flaviut/fan-controller/fan-controller.kicad_pcb

## KiCad design fan-controller.kicad_pcb (2024-07-13)

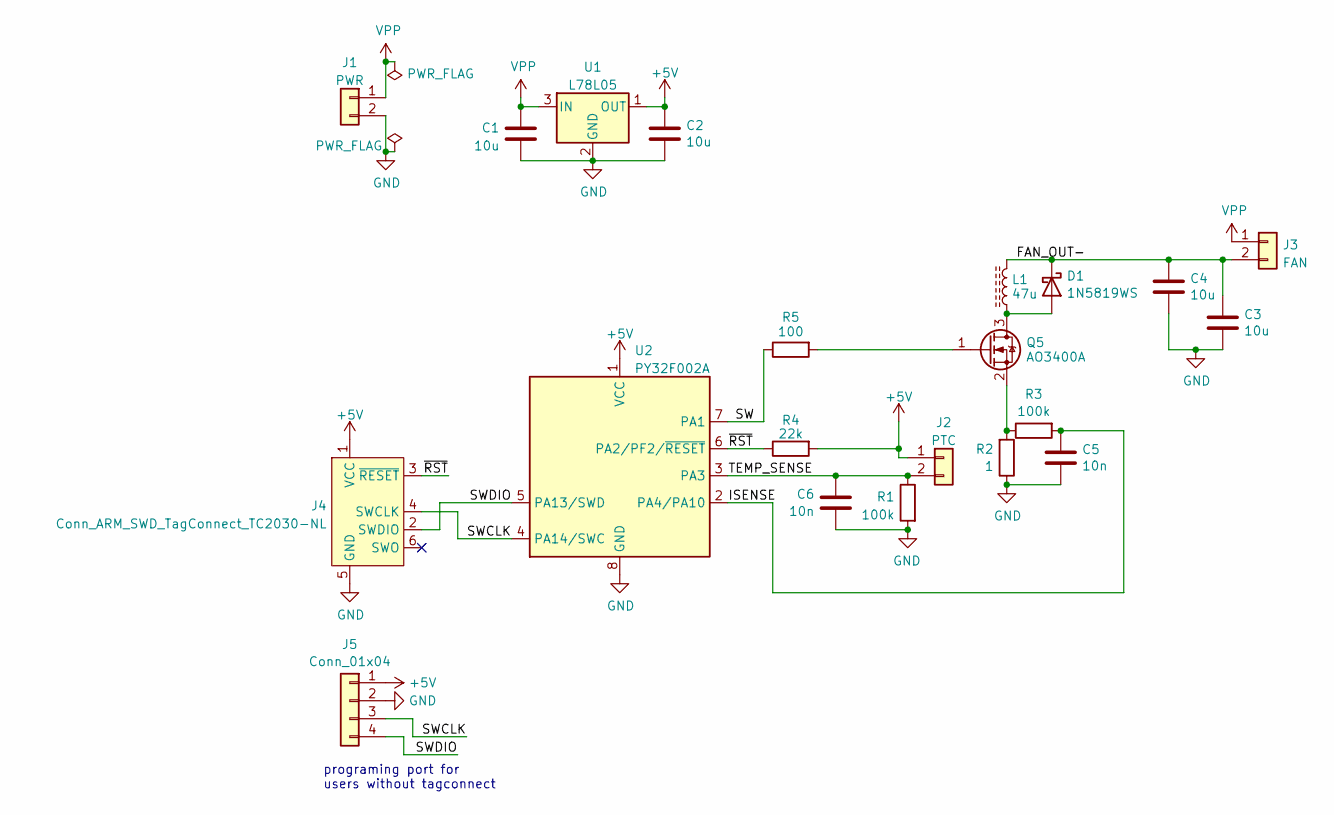
[picture p1: schematic fan-controller.kicad_sch]

Parts:
C1, C2, C3, C4: 10u; R_1206_3216Metric; LCSC C13585
C5, C6: 10n; R_0402_1005Metric; LCSC C15195
D1: 1N5819WS; D_SOD-323_HandSoldering; LCSC C191023
J1: PWR; JST_XH_S2B-XH-A_1x02_P2.50mm_Horizontal; LCSC C163035
J2: PTC; JST_XH_S2B-XH-A_1x02_P2.50mm_Horizontal; LCSC C163035
J3: FAN; JST_XH_S2B-XH-A_1x02_P2.50mm_Horizontal; LCSC C163035
J4: Conn_ARM_SWD_TagConnect_TC2030-NL; Tag-Connect_TC2030-IDC-NL_2x03_P1.27mm_Vertical
J5: Conn_01x04; PinHeader_1x04_P2.54mm_Vertical
L1: 47u; L_Abracon_ASPI-4030S; LCSC C54731
Q5: AO3400A; SOT-23; LCSC C20917
R1, R3: 100k; R_0402_1005Metric; LCSC C25741
R2: 1; R_0805_2012Metric; LCSC C25271
R4: 22k; R_0402_1005Metric; LCSC C25768
R5: 100; R_0402_1005Metric; LCSC C25076
U1: L78L05; SOT-89-3; LCSC C71136
U2: PY32F002A; SOIC-8_3.9x4.9mm_P1.27mm; LCSC C5292060

Connections:
+5V: C2.1, J2.1, J4.1 (VCC), J5.1, R4.2, U1.1 (OUT), U2.1 (VCC)
/FAN_OUT-: C3.1, C4.1, D1.1 (K), J3.2, L1.2
/ISENSE: C5.1, R3.2, U2.2 (PA4/PA10)
/SW: R5.1, U2.7 (PA1)
/SWCLK: J4.4 (SWCLK), J5.3, U2.4 (PA14/SWC)
/SWDIO: J4.2 (SWDIO), J5.4, U2.5 (PA13/SWD)
/TEMP_SENSE: C6.1, J2.2, R1.1, U2.3 (PA3)
/~RST: J4.3 (~RESET), R4.1, U2.6 (PA2/PF2/~RESET)
GND: C1.2, C2.2, C3.2, C4.2, C5.2, C6.2, J1.2, J4.5 (GND), J5.2, R1.2, R2.1, U1.2 (GND), U2.8 (GND)
unnamed: D1.2 (A), L1.1, Q5.3 (D)
unnamed: Q5.1 (G), R5.2
unnamed: Q5.2 (S), R2.2, R3.1
VPP: C1.1, J1.1, J3.1, U1.3 (IN)

Notes on the sheet:
programing port for users without tagconnect

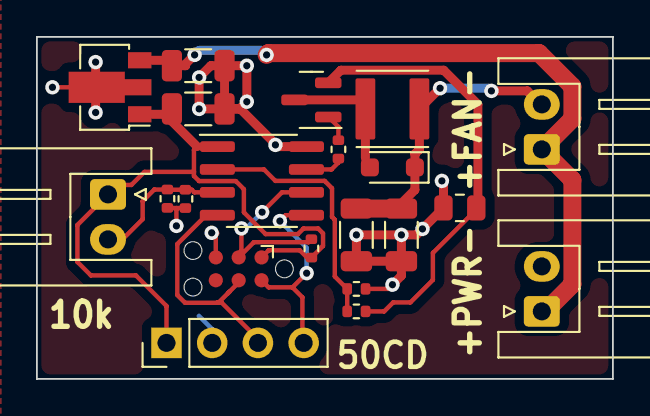
[picture p2: board fan-controller.kicad_pcb from above]

Board: 2 copper layers, 32.0 x 19.0 mm, 21 parts (0 on the bottom side), 13 nets.
