flaviut/fan-controller/(threads)

Thread 1 (2024-11-21):

Change cpu type

yabba222, 2024-11-21:
You use very hard to buy chip PY32.
Why use it ?

How convert thise project to eg. AVRTiny ?

flaviut, 2024-11-21:
On the contrary, [I find these very easy to buy](https://www.lcsc.com/mobile/products/Microcontrollers-MCU-MPU-SOC_11329.html?keyword=Py32), especially in China, where I had these boards made. The reason I choose it was for the learning experience, and because these chips are $0.10.

If you'd like to fork the project and port it to an atmega, I'd be happy to place a link in the readme for anyone who is a fan of that chip.

Thread 2 (2024-12-05):

Request for binary file

yabba222, 2024-12-05:
Can you attach the bin file to the project  ? - I admit that I have some difficulties with compilation and I just want to silence my Qidi Q1 - I will just try to upload the fw to the processor.

flaviut, 2024-12-05:
This was just my personal experimentation. There's no documentation, and any readme files you may have found are wrong. Unfortunately I don't have time to write better docs right now.

For the toolchain, the documentation is wrong. I've only tested this with arm-none-eabi gcc version 14.2.0 from Arch Linux repos. The project uses very recent C++ features which older compilers do not support.

yabba222, 2024-12-05:
ok, so you publish something that no one will ever make again from your
materials. So all my work for nothing? At least send me to my email the
*.bin file that you generated on your computer so I can use it in my fan
controller, you know, I really had a hard time making the board, ordering
parts etc.

W dniu czw., 5 gru 2024 o 18:21 Flaviu Tamas ***@***.***>
napisał(a):

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

flaviut, 2024-12-05:
Here's the files for a build off the main branch. I typically flash these using `make flash`, which ends up calling `pyocd load ./Build/app.hex -t py32f002ax5 --config ./Misc/pyocd.yaml`.

I do this from the firmware folder.

I'm not sure which programmer hardware you're using, so it may or may not work. I have only tested it with a cmsis-dap programmer.

[Build.zip](https://github.com/user-attachments/files/18030011/Build.zip)
