flaviut/fan-controller/(commit log)

2023-02-06 Fix ERC
    [fan-controller.kicad_pcb, fan-controller.kicad_sch]
2023-03-10 Final touch-ups
    [fan-controller.kicad_pcb, fan-controller.kicad_sch]
2023-03-29 Fix flyback diode & add output sense
    [fan-controller.kicad_pcb, fan-controller.kicad_sch]
2023-03-29 Tweak schematic
    [fan-controller.kicad_sch]
2023-03-29 Switch boilerplate
2023-03-29 hardware bug fixes
    [fan-controller.kicad_pcb, fan-controller.kicad_sch]
2023-03-30 Fix circuit mistakes
    [fan-controller.kicad_pcb, fan-controller.kicad_sch]
2023-04-07 Fix some bugs & add PWM jumper
    [fan-controller.kicad_pcb, fan-controller.kicad_sch]
2023-06-20 Simplify circuit
    [fan-controller.kicad_pcb, fan-controller.kicad_sch]
2023-07-21 Fix dumb errors (wrong part #)
    [fan-controller.kicad_pcb, fan-controller.kicad_sch]
2023-07-21 Update for actual 10k thermistor
2023-08-20 Implement final functionality
    [duty_vs_current.ods, voltage-vs-speed.ods]
2023-09-10 Update comments for power
2023-09-13 Increase refresh rate
    Reduces the impact of noise on the results
    [logic.c, main.c]
2023-09-13 Add additional tests for invariants
    And fix bugs when unexpected values showed up
    [logic.c, main.c]
2023-09-13 Improve hardware reliability
    Current sense + low-pass temperature filter at 100Hz cutoff
    [duty_vs_current.ods, fan-controller.kicad_pcb, fan-controller.kicad_sch]
2023-09-13 Switch to 10k thermistor in hardware
    easier to find, and the on-board resistor is still 100kΩ so power
    consumption is still low
    [fan-controller.kicad_pcb]
2024-07-13 Update LCSC part numbers
    [fan-controller.kicad_pcb, fan-controller.kicad_sch]
2024-07-13 Reduce temperature bounds
